il-dionigi/Systems-Design-F19/braymond/test_image.png

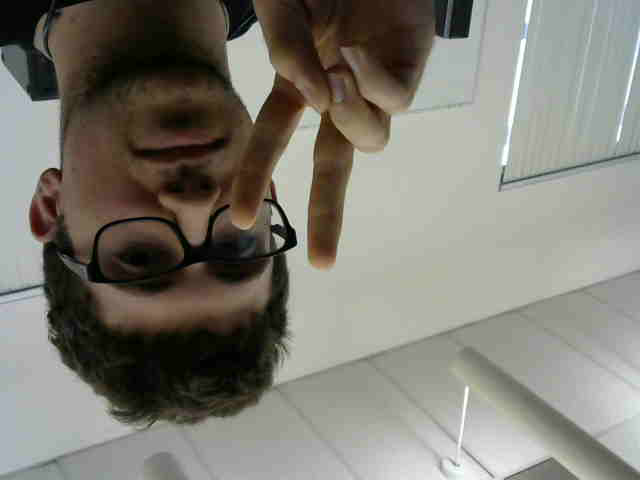
braymond/test_image.png
