il-dionigi/Systems-Design-F19/rhandelin/SnapshotTest.jpg

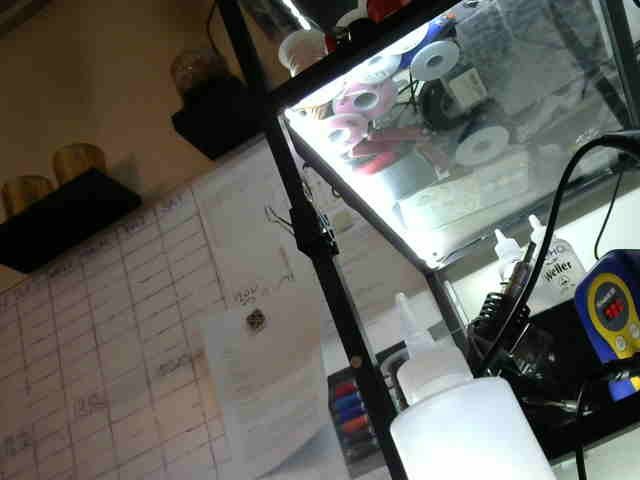
rhandelin/SnapshotTest.jpg
