il-dionigi/Systems-Design-F19/andrew/Report4.docx

Action Items Done this Week:

- Made a UI App using PyQT (Linux or Windows deployable) to programmatically write the role ID’s to SD Cards, and to burn Raspberry Images. (We may remove the burning the raspberry image and instead choose to burn the raspberry images to all the sd cards first, and then have this program only write roleid’s…)

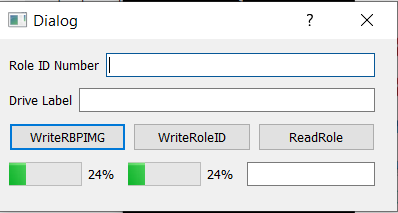
[picture p3: figure]

- In the backend of my WebApp for synchronization, I added the BLE code changes. So now hitting the button from the frontend will now trigger a BLE event corresponding to telling a device what color he will be displaying.

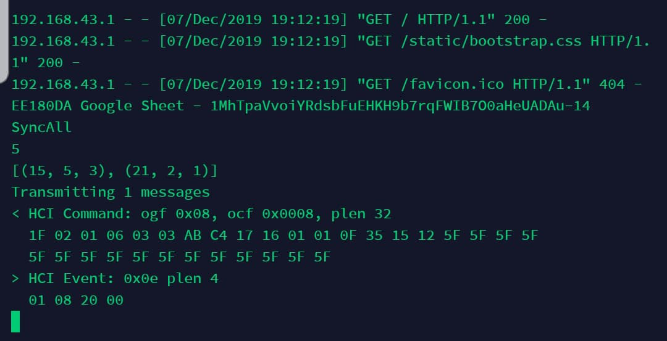
[picture p4: figure]

- Fixed a bug with the Flask server 404ing during system integration
- Fixed a networking hotspot bug, so the website now displays well in landscape mode (sadly not portrait mode as seen in the below picture. Still works though).

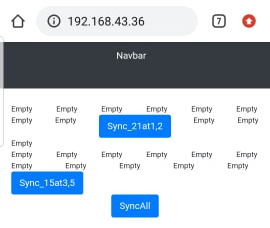
[picture p5: figure]

Action Items for before the presentation:

- Make a video possibly, and make this more robust before demo day.
