il-dionigi/Systems-Design-F19/Mk1 Design/pixelPi/settings.csv

L | X | Y | ID
1 | 0 | 0 | 0
