il-dionigi/Systems-Design-F19/braymond/python_script.png

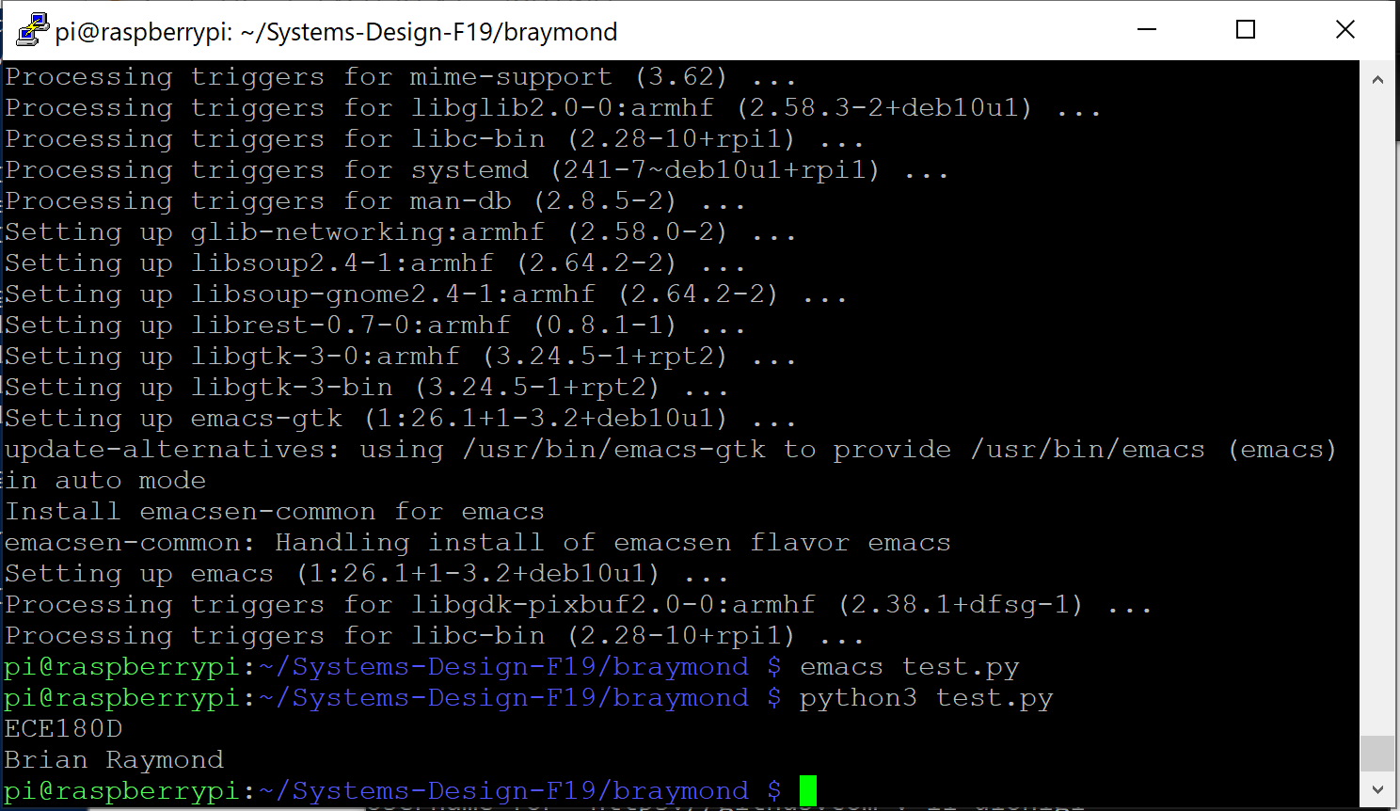
braymond/python_script.png
