il-dionigi/Systems-Design-F19/czaloom/Misc/img.jpg

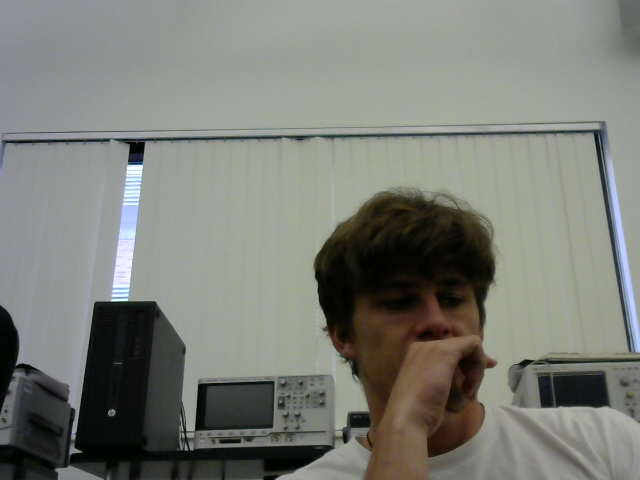
czaloom/Misc/img.jpg
