il-dionigi/Systems-Design-F19/rhandelin/PCB-IR/oscilloscope.png

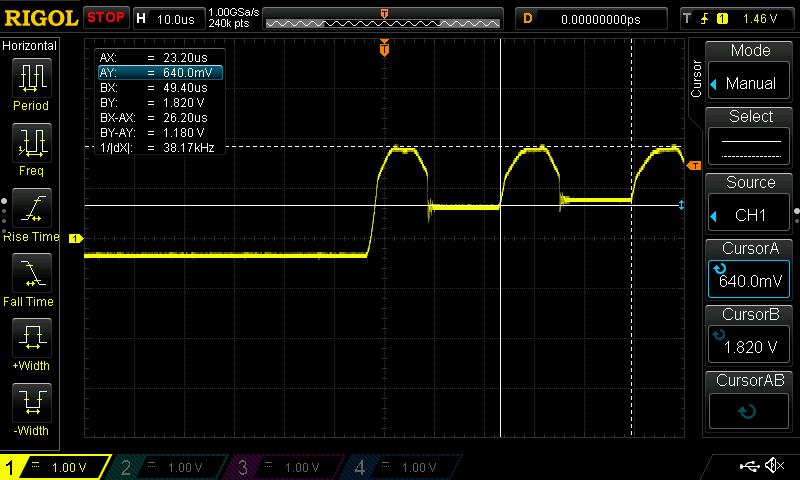
rhandelin/PCB-IR/oscilloscope.png
