il-dionigi/Systems-Design-F19/rhandelin/PCB-LED_REV2/LCSC_Exported_20191123_071011.xlsx

LCSC Part Number | Manufacture Part Number | Manufacturer | Package | Customer # | Description | RoHS | Order Qty. | Min\Mult Order Qty. | Unit Price | Order Price | Product Link
C162732 | 1N4001W | Shandong Jingdao Microelectronics | SOD-123F |  | 50V 1A 1.1V @ 1A SOD-123F Diodes - General Purpose RoHS | - | 150 | 50\50 | 0.0065 | 0.975 | https://lcsc.com/product-detail/Diodes-General-Purpose_Shandong-Jingdao-Microelectronics-1N4001W_C162732.html
C2456 | 1N4001 | MDD(Microdiode Electronics) | DO-41 |  | 50V 1A 1.1V @ 1A DO-41 Diodes - General Purpose RoHS | - | 100 | 50\50 | 0.0095 | 0.95 | https://lcsc.com/product-detail/Diodes-General-Purpose_MDD-Microdiode-Electronics-1N4001_C2456.html
C17024 | CL21A106KPFNNNE | Samsung Electro-Mechanics | 0805 |  | 10uF 10V 0805 Multilayer Ceramic Capacitors MLCC - SMD/SMT RoHS | - | 350 | 50\50 | 0.0121 | 4.235 | https://lcsc.com/product-detail/Multilayer-Ceramic-Capacitors-MLCC-SMD-SMT_Samsung-Electro-Mechanics-CL21A106KPFNNNE_C17024.html
C126351 | RC0805FR-0747KL | YAGEO | 0805 |  | 47K ±1% 1/8W 0805 Chip Resistor - Surface Mount RoHS | - | 200 | 50\50 | 0.0046 | 0.92 | https://lcsc.com/product-detail/Chip-Resistor-Surface-Mount_YAGEO-RC0805FR-0747KL_C126351.html
C114586 | WS2812B-B | Worldsemi | 5050 |  | Surface Mount 5050 Light Emitting Diodes (LED) RoHS | - | 1900 | 5\5 | 0.065 | 123.5 | https://lcsc.com/product-detail/Light-Emitting-Diodes-LED_Worldsemi-WS2812B-B_C114586.html
C277502 | AC0805KRX7R9BB104 | YAGEO | 0805 |  | 100nF 50V 0805 Multilayer Ceramic Capacitors MLCC - SMD/SMT RoHS | - | 1900 | 20\20 | 0.0104 | 19.76 | https://lcsc.com/product-detail/Multilayer-Ceramic-Capacitors-MLCC-SMD-SMT_YAGEO-AC0805KRX7R9BB104_C277502.html
C91552 | C91552 | BOOMELE(Boom Precision Elec) | 2.54MM |  | 2.54MM Pin Header & Female Header RoHS | - | 200 | 50\50 | 0.014 | 2.8 | https://lcsc.com/product-detail/Pin-Header-Female-Header_BOOMELE-Boom-Precision-Elec-C91552_C91552.html
C72048 | IRM-56384 | Everlight Elec | Plugin |  | Plugin Infrared Receivers RoHS | - | 310 | 1\1 | 0.0909 | 28.179 | https://lcsc.com/product-detail/Infrared-Receivers_Everlight-Elec-IRM-56384_C72048.html
