il-dionigi/Systems-Design-F19/rhandelin/PCB-LED_REV2/rev2.brd

## EAGLE design rhandelin/PCB-LED_REV2/rev2.brd (2019-11-22)

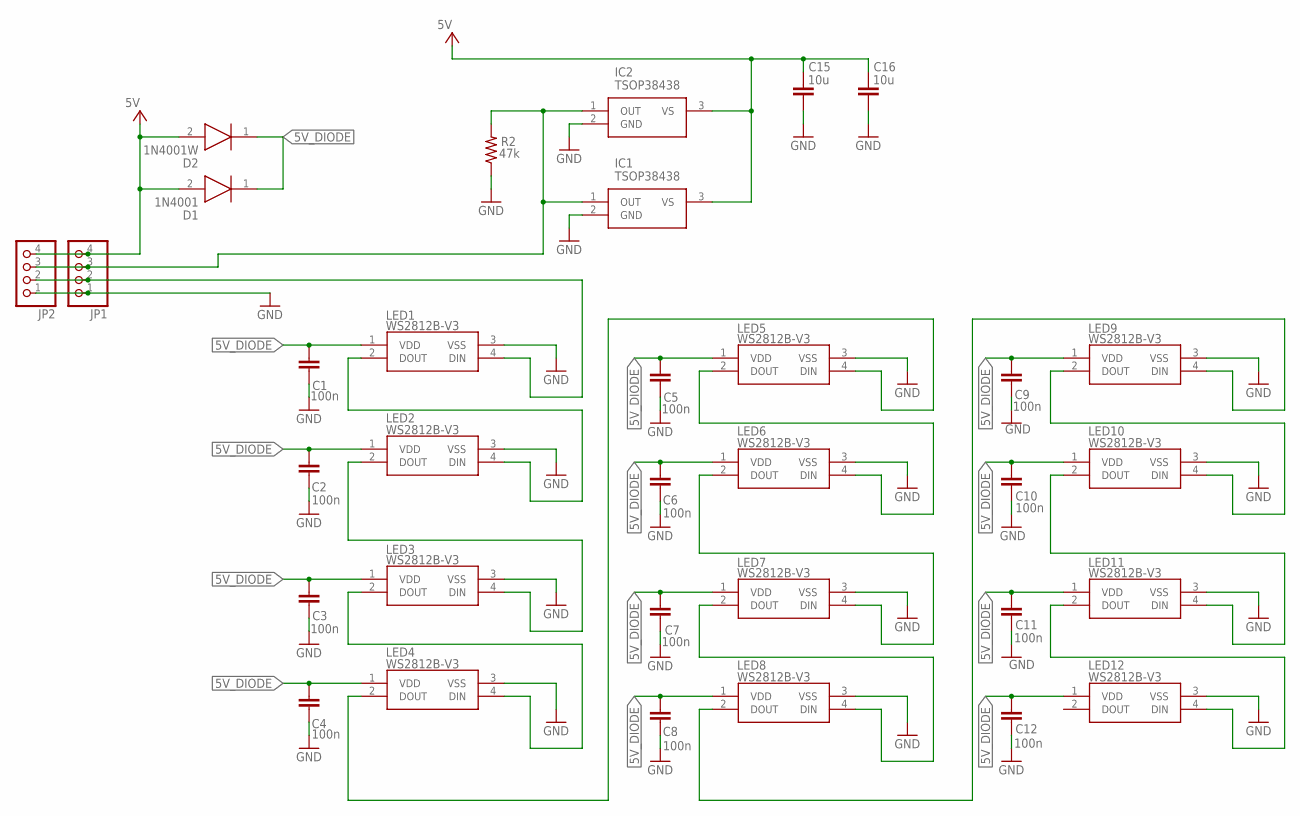
[picture p11: schematic rev2.sch]

Parts:
C1, C2, C3, C4, C5, C6, C7, C8, C9, C10, C11, C12: 100n; C0805
C15, C16: 10u; C0805
D1: 1N4001; DIOAD1405W86L465D235
D2: 1N4001W
IC1, IC2: TSOP38438; TSOP38238
JP1, JP2: PINHD-1X4; 1X04
LED1, LED2, LED3, LED4, LED5, LED6, LED7, LED8, LED9, LED10, LED11, LED12: WS2812B-V3; WS2812BV3
R2: 47k; R0805

Connections:
5V: C15.2, C16.2, D1.2 (A), D2.2 (A), IC1.3 (VS), IC2.3 (VS), JP1.4, JP2.4
5V_DIODE: C1.2, C2.1, C3.2, C4.1, C5.2, C6.1, C7.2, C8.1, C9.2, C10.1, C11.2, C12.1, D1.1 (K), D2.1 (K), LED1.1 (VDD), LED2.1 (VDD), LED3.1 (VDD), LED4.1 (VDD), LED5.1 (VDD), LED6.1 (VDD), LED7.1 (VDD), LED8.1 (VDD), LED9.1 (VDD), LED10.1 (VDD), LED11.1 (VDD), LED12.1 (VDD)
GND: C1.1, C2.2, C3.1, C4.2, C5.1, C6.2, C7.1, C8.2, C9.1, C10.2, C11.1, C12.2, C15.1, C16.1, IC1.2 (GND), IC2.2 (GND), JP1.1, JP2.1, LED1.3 (VSS), LED2.3 (VSS), LED3.3 (VSS), LED4.3 (VSS), LED5.3 (VSS), LED6.3 (VSS), LED7.3 (VSS), LED8.3 (VSS), LED9.3 (VSS), LED10.3 (VSS), LED11.3 (VSS), LED12.3 (VSS), R2.1
unnamed: LED1.2 (DOUT), LED2.4 (DIN)
unnamed: IC1.1 (OUT), IC2.1 (OUT), JP1.3, JP2.3, R2.2
unnamed: JP1.2, JP2.2, LED1.4 (DIN)
unnamed: LED3.2 (DOUT), LED4.4 (DIN)
unnamed: LED2.2 (DOUT), LED3.4 (DIN)
unnamed: LED5.2 (DOUT), LED6.4 (DIN)
unnamed: LED4.2 (DOUT), LED5.4 (DIN)
unnamed: LED7.2 (DOUT), LED8.4 (DIN)
unnamed: LED6.2 (DOUT), LED7.4 (DIN)
unnamed: LED9.2 (DOUT), LED10.4 (DIN)
unnamed: LED8.2 (DOUT), LED9.4 (DIN)
unnamed: LED11.2 (DOUT), LED12.4 (DIN)
unnamed: LED10.2 (DOUT), LED11.4 (DIN)

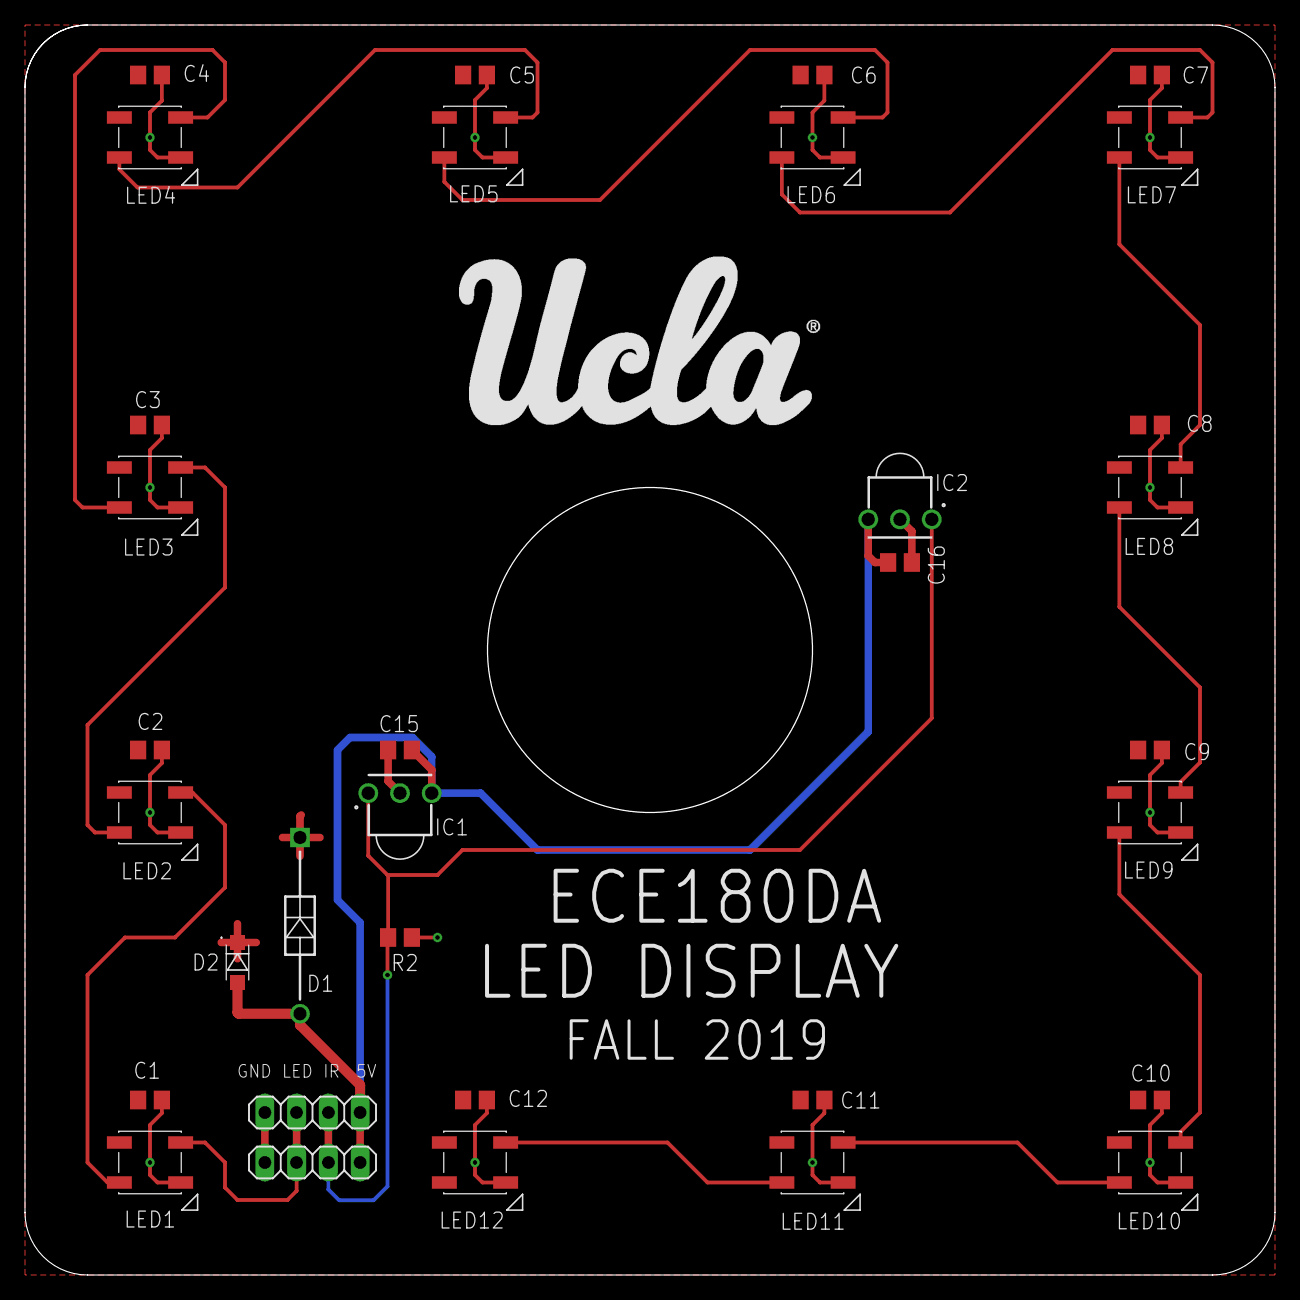
[picture p12: board rev2.brd from above]

Board: 2 copper layers, 100.0 x 100.0 mm, 33 parts (0 on the bottom side), 16 nets.
