il-dionigi/Systems-Design-F19/rhandelin/PCB-IR/irboard.brd

## EAGLE design rhandelin/PCB-IR/irboard.brd (2019-11-14)

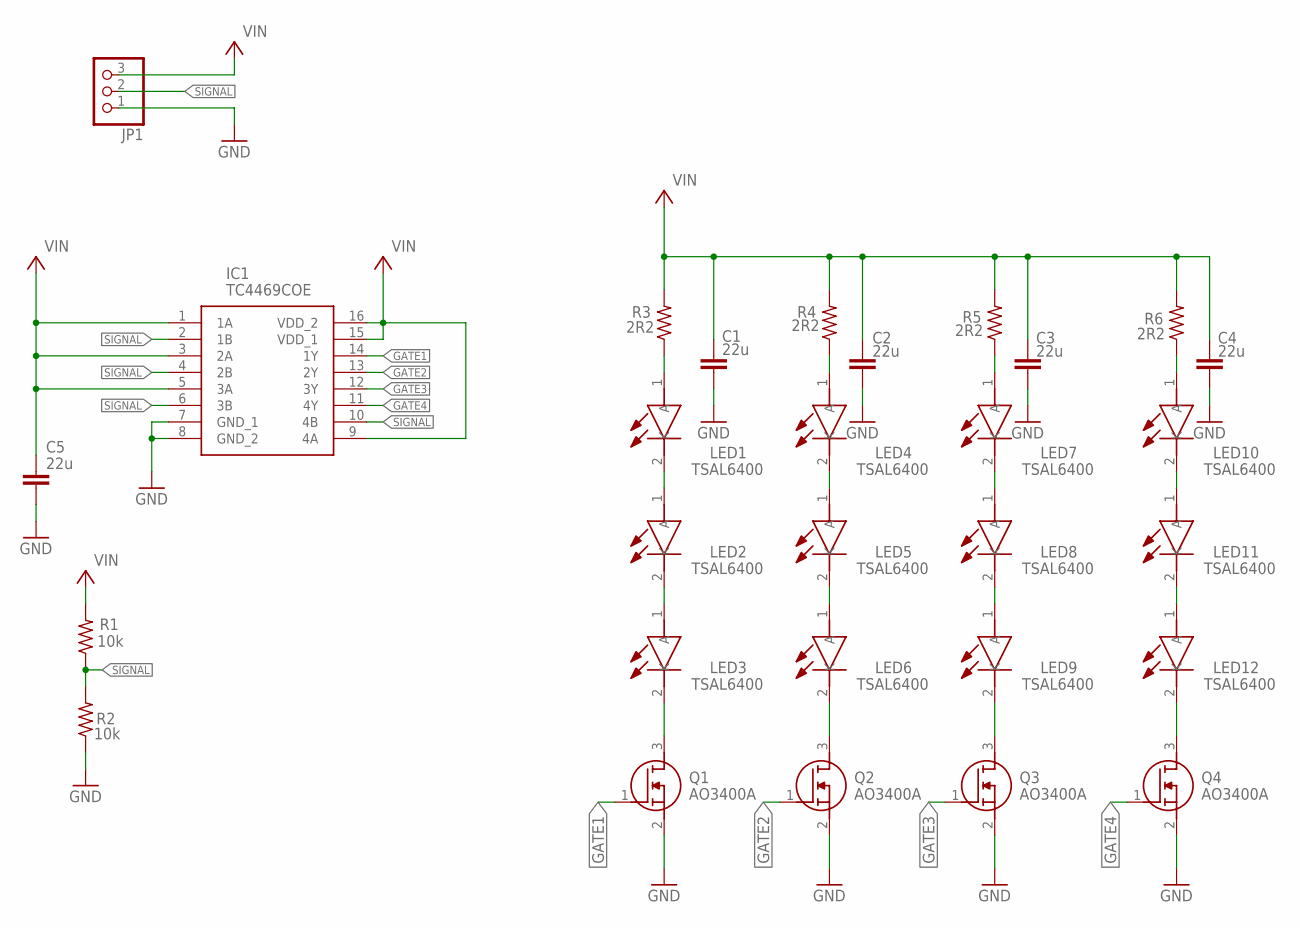
[picture p13: schematic irboard.sch]

Parts:
C1, C2, C3, C4, C5: 22u; C0805
IC1: TC4469COE; SOIC127P1034X264-16N
JP1: PINHD-1X3; 1X03
LED1, LED2, LED3, LED4, LED5, LED6, LED7, LED8, LED9, LED10, LED11, LED12: TSAL6400; TSAL6100
Q1, Q2, Q3, Q4: AO3400A; SOT95P280X125-3N
R1, R2: 10k; R0603
R3, R4, R5, R6: 2R2; R0603

Connections:
GATE1: IC1.14 (1Y), Q1.1 (G)
GATE2: IC1.13 (2Y), Q2.1 (G)
GATE3: IC1.12 (3Y), Q3.1 (G)
GATE4: IC1.11 (4Y), Q4.1 (G)
GND: C1.2, C2.2, C3.2, C4.2, C5.2, IC1.7 (GND_1), IC1.8 (GND_2), JP1.1, Q1.2 (S), Q2.2 (S), Q3.2 (S), Q4.2 (S), R2.1
unnamed: LED3.2 (K), Q1.3 (D)
unnamed: LED2.2 (K), LED3.1 (A)
unnamed: LED1.2 (K), LED2.1 (A)
unnamed: LED4.2 (K), LED5.1 (A)
unnamed: LED5.2 (K), LED6.1 (A)
unnamed: LED6.2 (K), Q2.3 (D)
unnamed: LED7.2 (K), LED8.1 (A)
unnamed: LED8.2 (K), LED9.1 (A)
unnamed: LED9.2 (K), Q3.3 (D)
unnamed: LED10.2 (K), LED11.1 (A)
unnamed: LED11.2 (K), LED12.1 (A)
unnamed: LED12.2 (K), Q4.3 (D)
unnamed: LED1.1 (A), R3.1
unnamed: LED4.1 (A), R4.1
unnamed: LED7.1 (A), R5.1
unnamed: LED10.1 (A), R6.1
SIGNAL: IC1.2 (1B), IC1.4 (2B), IC1.6 (3B), IC1.10 (4B), JP1.2, R1.1, R2.2
VIN: C1.1, C2.1, C3.1, C4.1, C5.1, IC1.1 (1A), IC1.3 (2A), IC1.5 (3A), IC1.9 (4A), IC1.15 (VDD_1), IC1.16 (VDD_2), JP1.3, R1.2, R3.2, R4.2, R5.2, R6.2

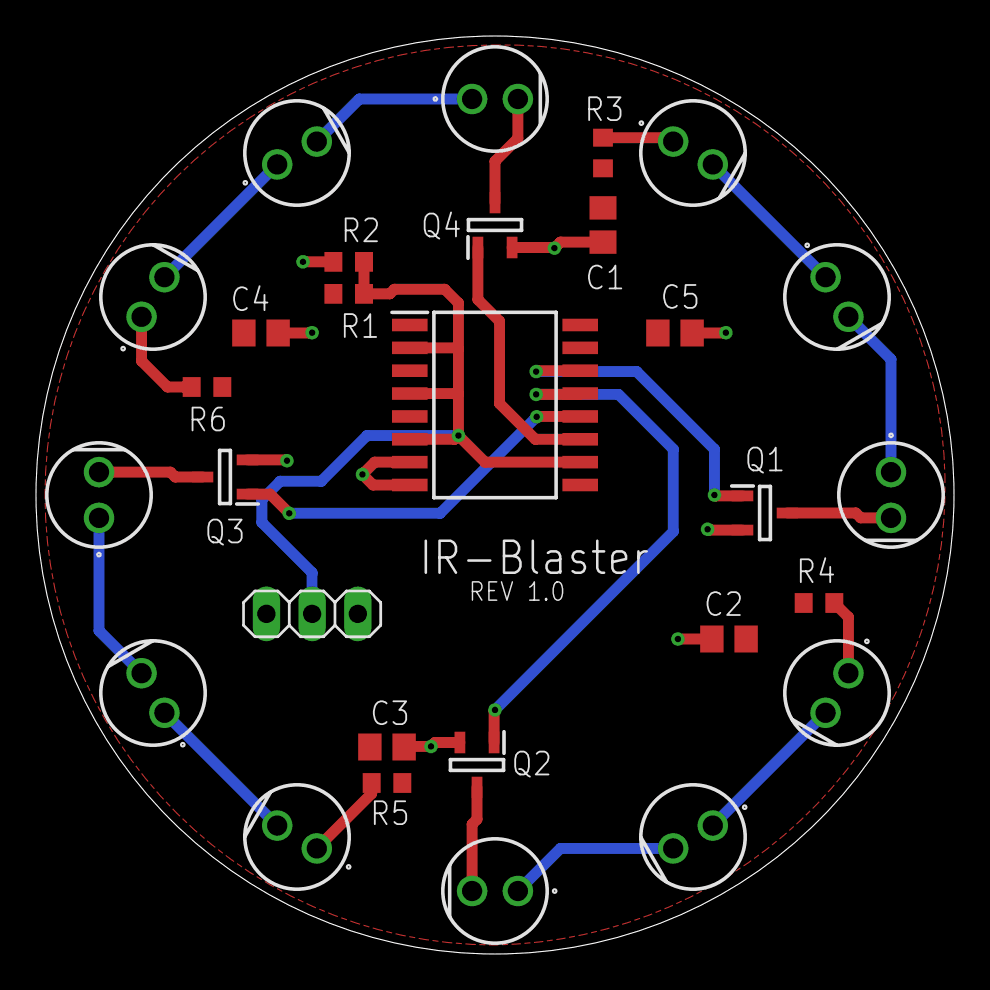
[picture p14: board irboard.brd from above]

Board: 2 copper layers, 51.0 x 51.0 mm, 29 parts (0 on the bottom side), 23 nets.
