il-dionigi/Systems-Design-F19/rhandelin/IR-Remote-Receiver-Python-Module/IRModuleExample.py

#!/usr/bin/env python3
"""IRModuleExample1, program to practice using the IRModule

Created Apr 30, 2018"""

"""
Copyright 2018 Owain Martin

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
pixels = neopixel.NeoPixel(board.D18, 12)

def remote_callback(code):

    # Codes listed below are for the
    # Sparkfun 9 button remote



#16582903
#16615543
#16599223
#16591063
#16623703
#16607383
#16586983
#16619623
#16603303



    if code == 16582903:
        print('Pressed: 1')
        pixels.fill((100,0,0))
        time.sleep(0.5)
        pixels.fill((0,0,0))
        time.sleep(3)
        pixels.fill((0,100,0))
        time.sleep(0.5)
        pixels.fill((0,0,0))


    elif code == 16615543:
        print('Pressed: 2')
        pixels.fill((0,100,0))
    elif code == 16599223:
        print('Pressed: 3')
        pixels.fill((0,0,100))
    elif code == 16591063:
        print('Pressed: 4')
    elif code == 16623703:
        print('Pressed: 5')
    elif code == 16607383:
        print('Pressed: 6')
    elif code == 16586983:
        print('Pressed: 7')
    elif code == 16619623:
        print('Pressed: 8')
    elif code == 16603303:
        print('Pressed: 9')
    elif code == 16593103:
        print('Pressed: 0')
        pixels.fill((255,255,255))
    elif code == 16605343:
        print('Pressed: Stop')
        pixels.fill((0,0,0))
    else:
       if code != -1:
         print(code)  # unknown code
    return

# set up IR pi pin and IR remote object
irPin = 16
ir = IRModule.IRRemote(callback='DECODE')
# using 'DECODE' option for callback will print out
# the IR code received in hexadecimal
# this can used to get the codes for whichever NEC
# compatable remote you are using

# set up GPIO options and set callback function required
# by the IR remote module (ir.pWidth)        
GPIO.setwarnings(False)
GPIO.setmode(GPIO.BCM)      # uses numbering outside circles
GPIO.setup(irPin,GPIO.IN)   # set irPin to input
GPIO.add_event_detect(irPin,GPIO.BOTH,callback=ir.pWidth)

ir.set_verbose(False) # verbose option prints outs high and low width durations (ms)
print('Starting IR remote ')
print('Use ctrl-c to exit program')

try:    
    time.sleep(5)

    # turn off verbose option and change callback function
    # to the function created above - remote_callback()
    print('Ready')
    ir.set_verbose(False)
    ir.set_callback(remote_callback)

    # This is where you could do other stuff
    # Blink a light, turn a motor, run a webserver
    # count sheep or mine bitcoin
    
    while True:
        time.sleep(1)

except:
    print('Removing callback and cleaning up GPIO')
    pixels.fill((0,0,0))
    ir.remove_callback()
    GPIO.cleanup(irPin)
