il-dionigi/Systems-Design-F19/(commit log)

2019-10-03 Adding FPS.py
    Showcases 2 methods for improving frames per second during runtime.
2019-10-11 camera stuff
2019-10-11 More camera
2019-10-12 Camera stuff
    capture script + image
2019-11-07 PCB Files
2019-11-07 Add Eagle Files
    [ledpcb.brd, ledpcb.sch]
2019-11-14 New Schematic/PCB
    [irboard.brd, irboard.sch, rev1.brd, rev1.sch]
2019-11-22 Update pcb
2019-11-22 Add Gerber
    [LCSC_Exported_20191123_071011.xlsx, rev2.brd, rev2.sch]
2019-12-06 update ledtest
2019-12-07 updated encoder
    Encoder now accepts list of arrays/tuples with the format for each being [id, x, y]
2019-12-07 MVP
    Project works with defined, unwatned behavior
    [settings.csv]
2019-12-07 Added reset
    Added reset to routine 0 and tested it works
    [settings.csv]
2019-12-10 routine in interrupt
    Routine now runs from the routine
2019-12-10 deleted settings
    muahahaha
    [settings.csv]
