il-dionigi/Systems-Design-F19/(notices)

Notices in the files:
rhandelin/IR-Remote-Receiver-Python-Module/IRModuleExample.py:
it under the terms of the GNU General Public License as published by
